crn565/OMPMV2/BOM_monitor_consumo_6_canales_mejorado_2026-09-29.csv

ID | Name | Designator | Footprint | Quantity | Manufacturer Part | Manufacturer | Supplier | Supplier Part | Pins | Contributor | JLCPCB Part Class | link
1 | 100uF | C1,C3,C4,C5,C6,C7 | CAP-TH_BD10.0-P5.00-D1.0-FD | 6 | 63YXF100MFFCT810X12.5 | Rubycon(红宝石) | LCSC | C324038 | 2 | LCSC | Extended Part
2 | 100nF | C2,C8,C9,C10,C11,C12 | CAP-TH_L11.5-W5.5-P10.00-D0.6 | 6 | CBB21-630V104JP10 | 东通电子 | LCSC | C2888191 | 2 | lcsc | Extended Part
3 | micro SD Card Reader | CN1 | CONN-TH_6P_PH2.0D-L-6P | 1 | 6PIN-2.0MM | null | LCSC | C9900021152 | 6 | lcsc
4 | 2.54-2P WZDK-R PITCH CONNECTOR | CN2 | CONN-TH_2.54-2P-WZDK-R-PITCH-CONNECTOR | 1 | 2.54-2P WZDK-R Pitch Connector | SHOU HAN(首韩) | LCSC | C49023803 | 2 | lcsc | Extended Part
5 | BAT54WS | D2,D3,D4,D5,D6,D7 | SOD-323_L1.8-W1.3-LS2.5-RD | 6 | BAT54WS | STARSEA | LCSC | C168799 | 2 | LCSC | Extended Part
6 | 10k | R1 | R0603 | 1 |  |  |  |  | 2 | LCEDA_Lib
7 | 22 | R2,R3 | R0603 | 2 |  |  |  |  | 2 | LCEDA_Lib
8 | hilink | U1 | HLK-5M05 HI-LINK 5V 5W | 1 | HLK-5M05 | Hi-Link |  | Hi-Link AC-DC Module 5V 1A - 5W | 4 | Hardware@Qube
9 | PZEM-004T ver. 3 | U2,U3,U4,U5,U7 | PZEM-004T VER. 3 | 5 |  |  |  |  | 8 | alexnino
10 | ZEM-004T ver. 3 | U6 | PZEM-004T VER. 3 | 1 |  |  |  |  | 8 | alexnino
11 | 0,96" Module 12864 | U9 | OLED-TH12864 | 1 | 1.3寸OLED显示屏12864 | null | LCSC | C9900014198 | 4 | lcsc | Extended Part | https://atta.szlcsc.comnull
12 | X2510WR-12-N0SN | U10 | CONN-TH_12P-P2.54_XKB-CONNECTIVITY_X2510WR-12-N0SN | 1 | X2510WR-12-N0SN | XKB Connection(中国星坤) | LCSC | C2882500 | 12 | LCSC | Extended Part
13 | JUMPER2 | U11,U12,U13,U14,U15,U16 | HDR-TH_2P-P2.54-V-M-1 | 6 | Jumper2 | null | LCSC | C2940092 | 2 | LCSC | Extended Part
14 | ESP32-DEVKITC-32D | U17 | COMM-SMD_ESP32-DEVKITC-32D | 1 | ESP32-DevKitC-32D | ESPRESSIF(乐鑫) | LCSC | C571181 | 38 | lcsc
15 | PS-5850DHB-3PNA | U18 | SW-TH_G-SWITCH_PS-585XX | 1 | PS-5850DHB-3PNA | G-Switch(品赞) | LCSC | C5155593 | 3 | lcsc | Extended Part
