crn565/OMPMV2/BOM_monitor_consumo_6_v32_2026-09-29.csv

ID | Name | Designator | Footprint | Quantity | Manufacturer Part | Manufacturer | Supplier | Supplier Part | Price | Pins | Contributor | JLCPCB Part Class | link
1 | 100nF | C2 | CAP-TH_L11.5-W5.5-P10.00-D0.6 | 1 | CBB21-630V104JP10 | 东通电子 | LCSC | C2888191 |  | 2 | lcsc | Extended Part
2 | 4700uF | C13 | CAP-TH_BD8.0-P3.50-D0.6-FD | 1 | 16YXJ470MFFCT78X11.5 | Rubycon(红宝石) | LCSC | C2905936 | 0.094 | 2 | lcsc | Extended Part
3 | 100nF | C14,C16,C17,C18 | GENERIC CERAMIC CAP | 4 | 000 | 000 |  | 000 |  | 2 | l.garol.545854 | Extended Part
4 | 10µF | C15,C20 | CONDENSATORE CERAMICO MULTISTRATO AZZURRO ROTONDO PICCOLO | 2 | CONDENSATORE CERAMICO MULTISTRATO AZZURRO ROTONDO PICCOLO | Officine PADANE | RICCADONNA LUCIANO | CONDENSATORE CERAMICO MULTISTRATO AZZURRO ROTONDO PICCOLO |  | 2 | paolonogara1972 | Extended Part
5 | 2.54-2P WZDK-R PITCH CONNECTOR | CN2 | CONN-TH_2.54-2P-WZDK-R-PITCH-CONNECTOR | 1 | 2.54-2P WZDK-R Pitch Connector | SHOU HAN(首韩) | LCSC | C49023803 | 0.018 | 2 | lcsc | Extended Part
6 | BUS RS485 | CN4 | CONN-TH_CONNECTOR | 1 | CONNECTOR | null | LCSC | C9900011140 |  | 4 | LCSC | Extended Part
7 | TSOP4838 | LED1 | SENSOR-TH_TSOP4X | 1 | TSOP4838 | VISHAY(威世) | LCSC | C124647 | 1.438 | 3 | LCSC | Extended Part
8 | BC32840TA | Q1 | TO-92-3_L4.9-W3.7-P2.54-L-A | 1 | BC32840TA | onsemi(安森美) | LCSC | C3201886 |  | 3 | lcsc | Extended Part
9 | 10k | R1,R4,R5,R6,R8 | R_AXIAL-0.4 | 5 |  |  |  |  |  | 2 | LCEDA_Lib
10 | 22 | R2,R3 | R_AXIAL-0.4 | 2 |  |  |  |  |  | 2 | LCEDA_Lib
11 | 1k | R7 | R_AXIAL-0.4 | 1 |  |  |  |  |  | 2 | LCEDA_Lib
12 | GT-TC072A-H055-L1 | SW1,SW2,SW3 | SW-SMD_G-SWITCH_GT-TC072X-HXXX-LX | 3 | GT-TC072A-H055-L1 | G-Switch(品赞) | LCSC | C5117862 | 0.133 | 3 | lcsc | Extended Part
13 | 1.77" TFT Display | U1 | 1.77" TFT DISPLAY | 1 |  |  |  |  |  | 8 | fasercomn
14 | HLK-PM01 | U2 | PWRM-TH_HLK-PM01 | 1 | HLK-PM01 | HI-LINK(海凌科) | LCSC | C209903 | 3.102 | 4 | LCSC | Extended Part
15 | MicroSD Card Adapter | U3 | MICROSD CARD READER | 1 |  |  |  |  |  | 6 | pedromancano
16 | ESP32-DEVKITC-32D | U17 | COMM-SMD_ESP32-DEVKITC-32D | 1 | ESP32-DevKitC-32D | ESPRESSIF(乐鑫) | LCSC | C571181 |  | 38 | lcsc
17 | DHT11 | U23 | SENSOR-TH_DHT11 | 1 | DHT11 | 广州奥松 | LCSC | C117051 | 1.462 | 4 | LCSC | Extended Part
