crn565/OMPMV2/Schematic_monitor_consumo_6_v32_2026-09-29.pdf

## APPLICATION GPIO Buttons 4,32,33

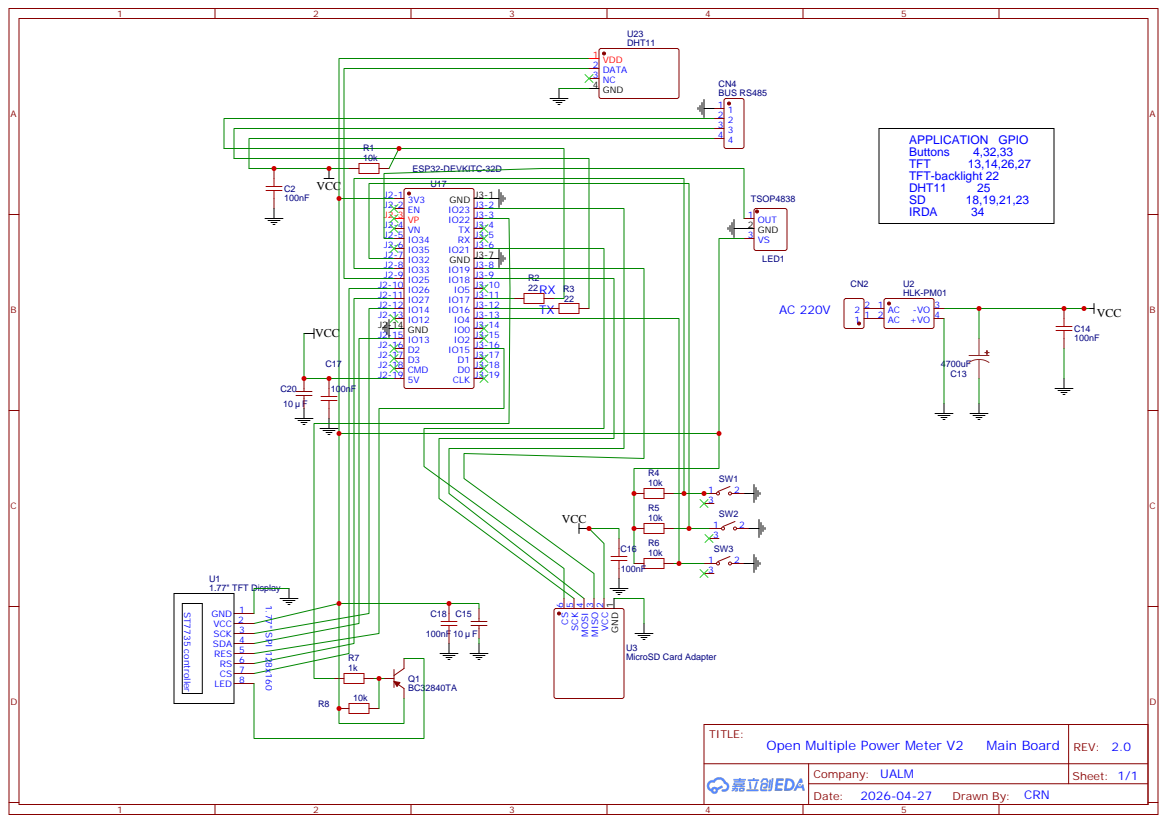
[picture p2: page 1]
