crn565/OMPMV2/PCB_PCB_monitor_consumo_6_v33_2026-09-29.pdf

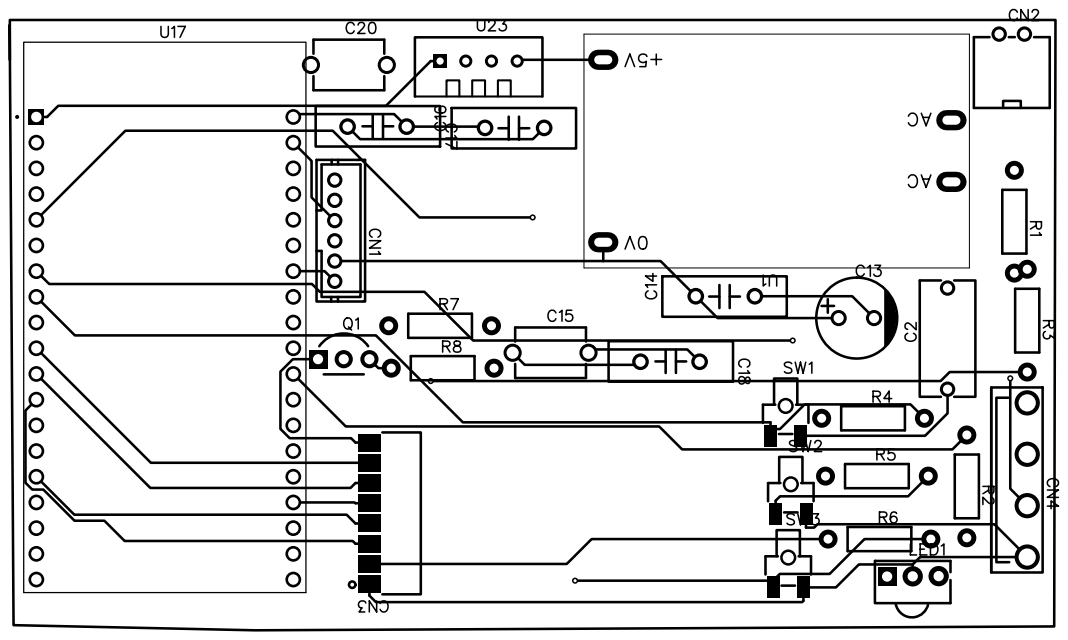
[picture p3: page 1]
